ryood/ArduinoLFO/CameraZOOM-20180402085916734.jpg

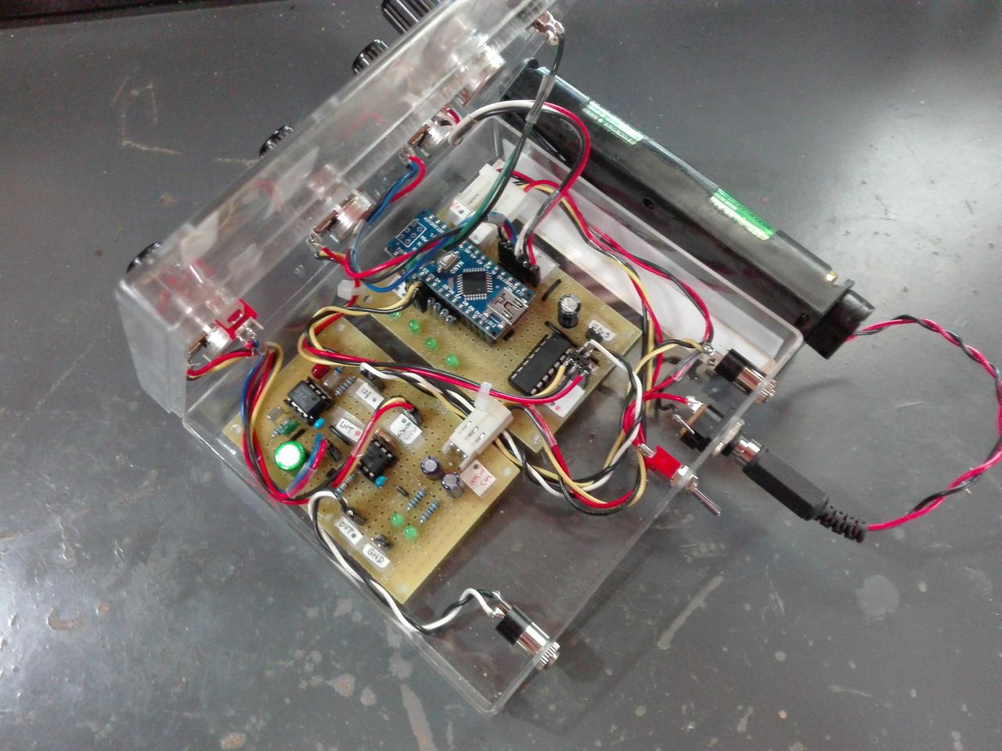
CameraZOOM-20180402085916734.jpg
