ryood/ArduinoLFO/CameraZOOM-20180402085851424.jpg

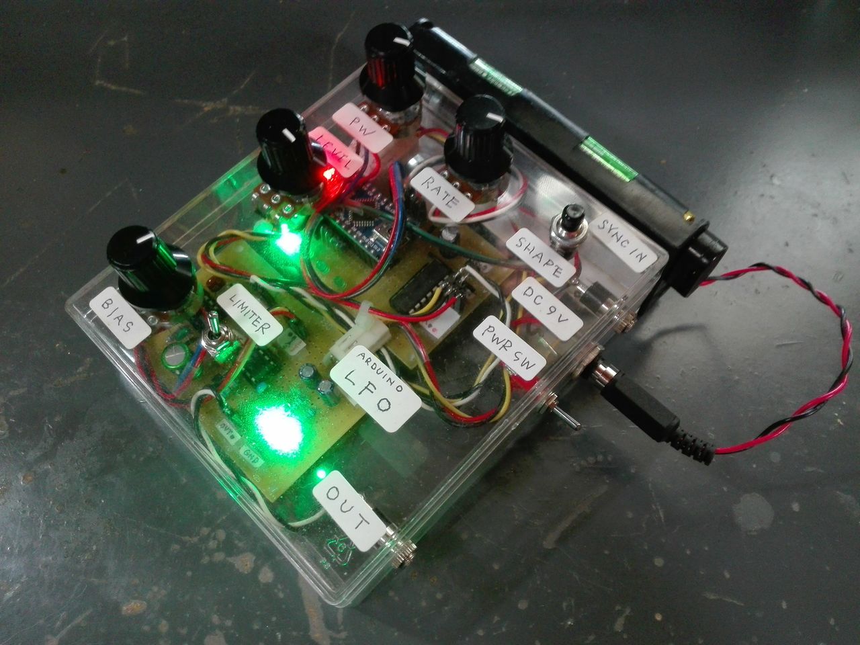
CameraZOOM-20180402085851424.jpg
