ryood/ArduinoLFO/Arduino LFO ブロック図.jpg

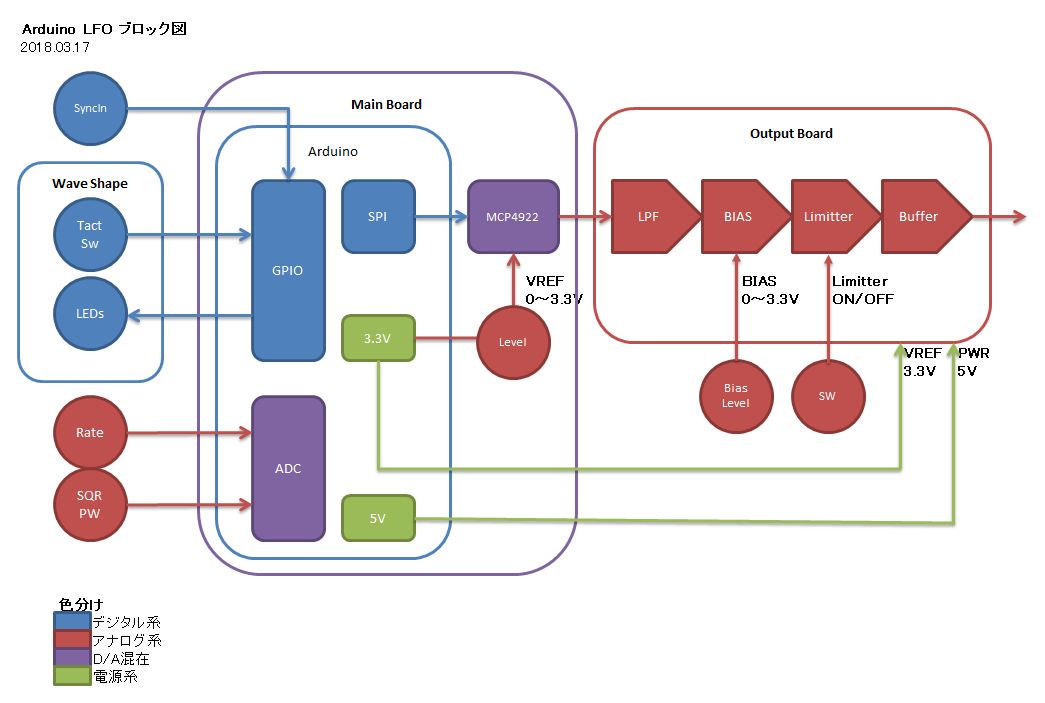
Arduino LFO ブロック図.jpg
