ryood/ArduinoLFO/ArduinoLFOケース内配線_ブレッドボード.png

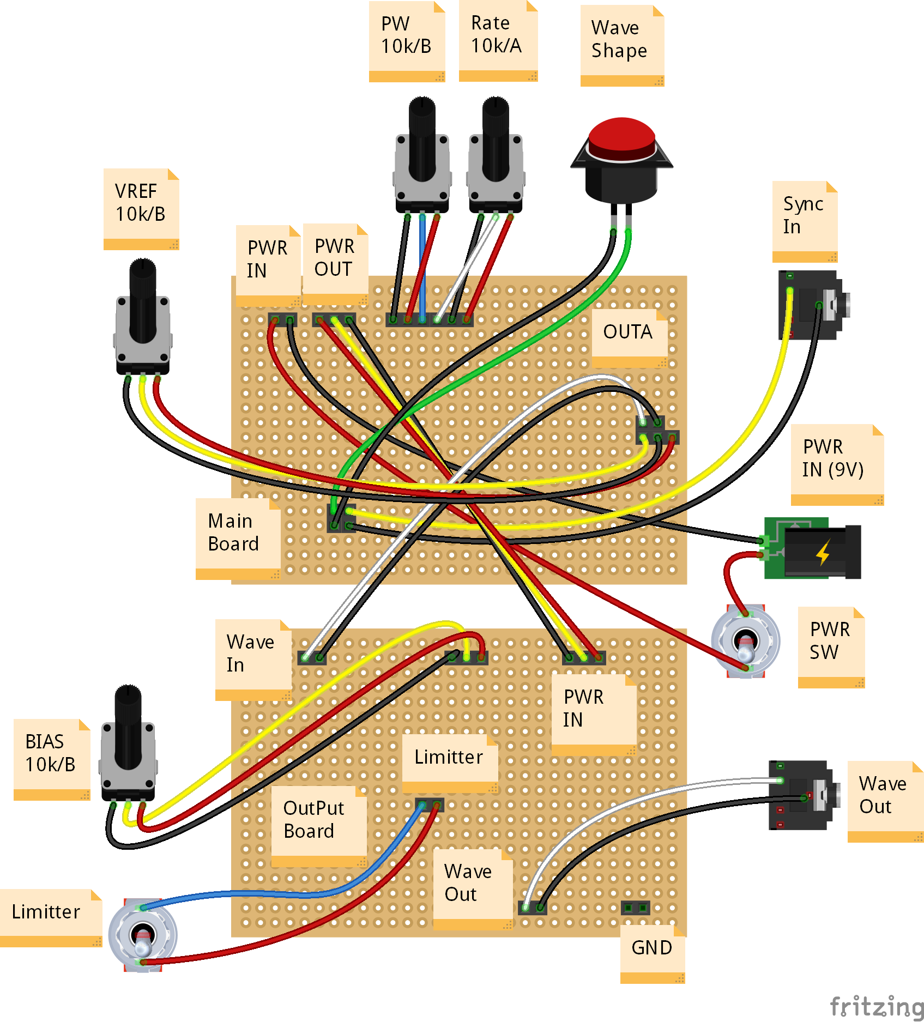
ArduinoLFOケース内配線_ブレッドボード.png
