ryood/ArduinoLFO/eagle/Arduino_LFO_MainBard_brd.png

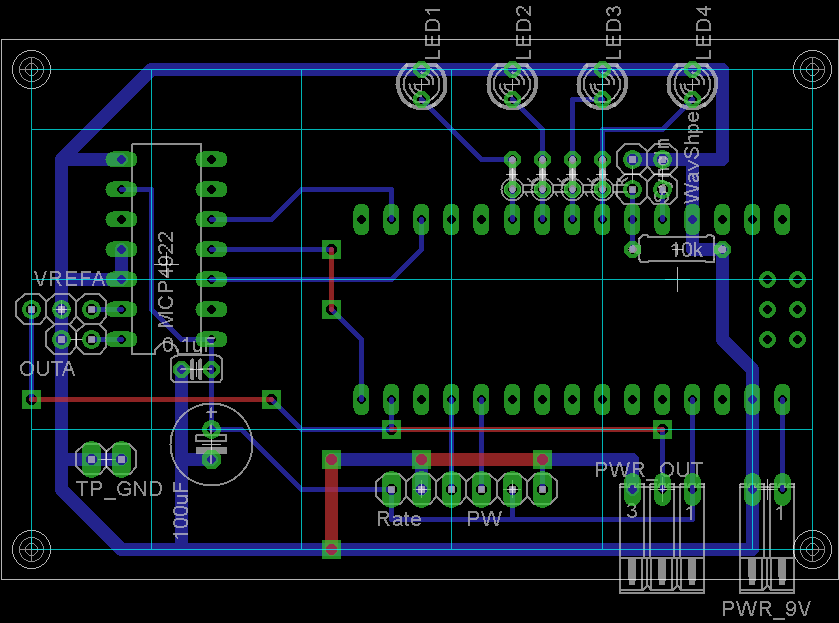
eagle/Arduino_LFO_MainBard_brd.png
