ryood/ArduinoLFO/eagle/Arduino_LFO_MainBard_sch.png

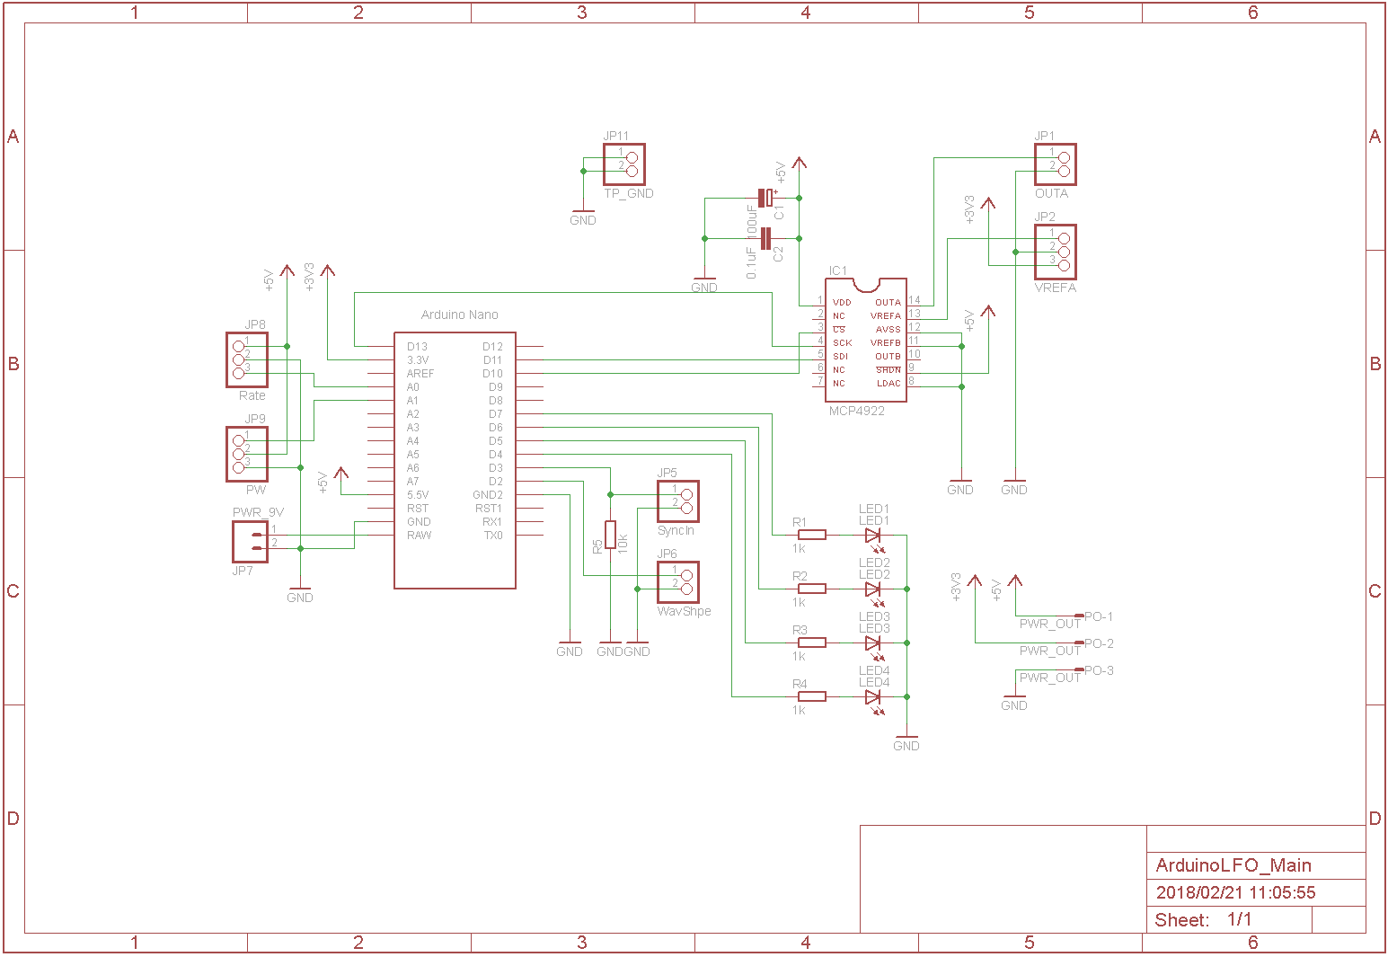
eagle/Arduino_LFO_MainBard_sch.png
