ryood/ArduinoLFO/eagle/ArduinoLFO_Output_Board_brd.png

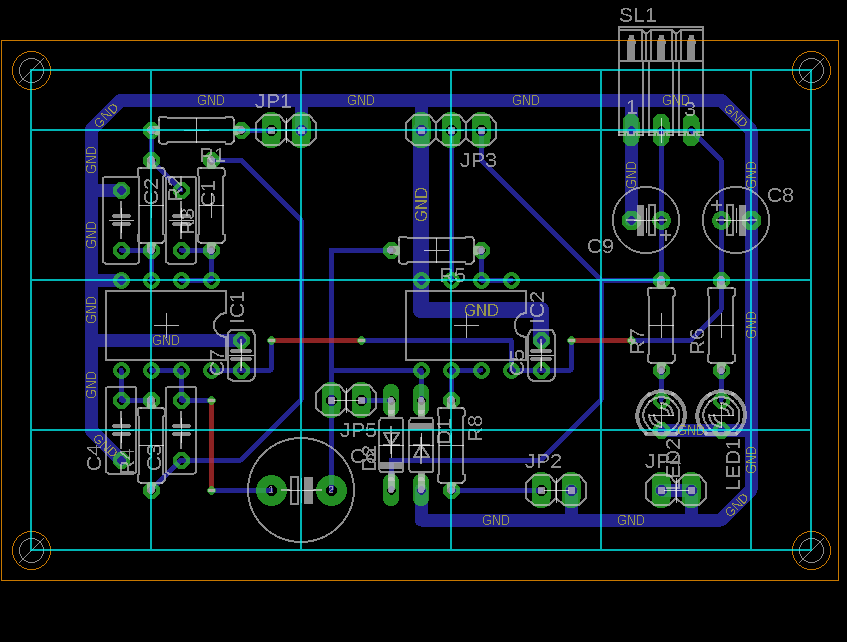
eagle/ArduinoLFO_Output_Board_brd.png
