ryood/ArduinoLFO/eagle/ArduinoLFO_Output_Board_sch.png

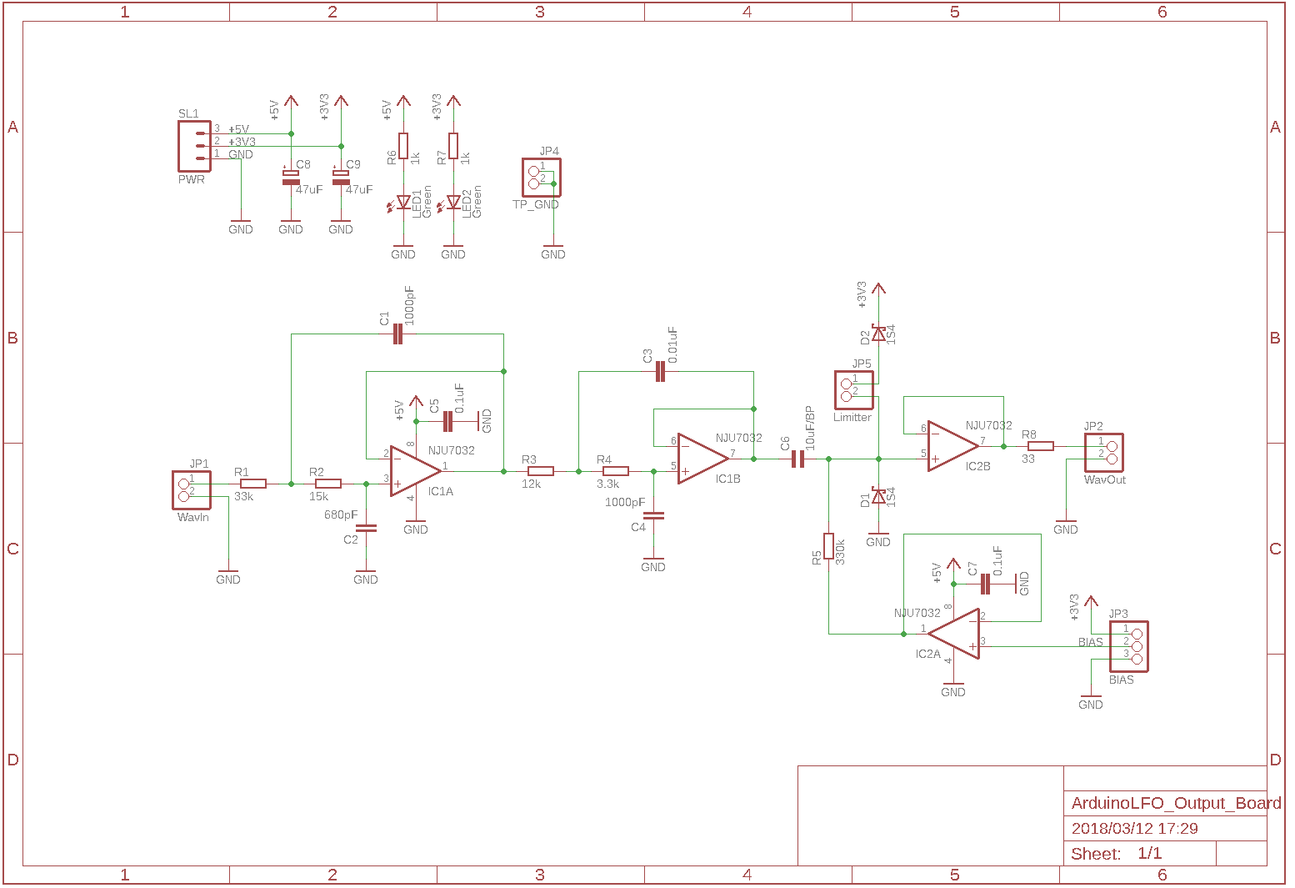
eagle/ArduinoLFO_Output_Board_sch.png
