ryood/ArduinoLFO/fritzing/ArduinoLFO_ブレッドボード.png

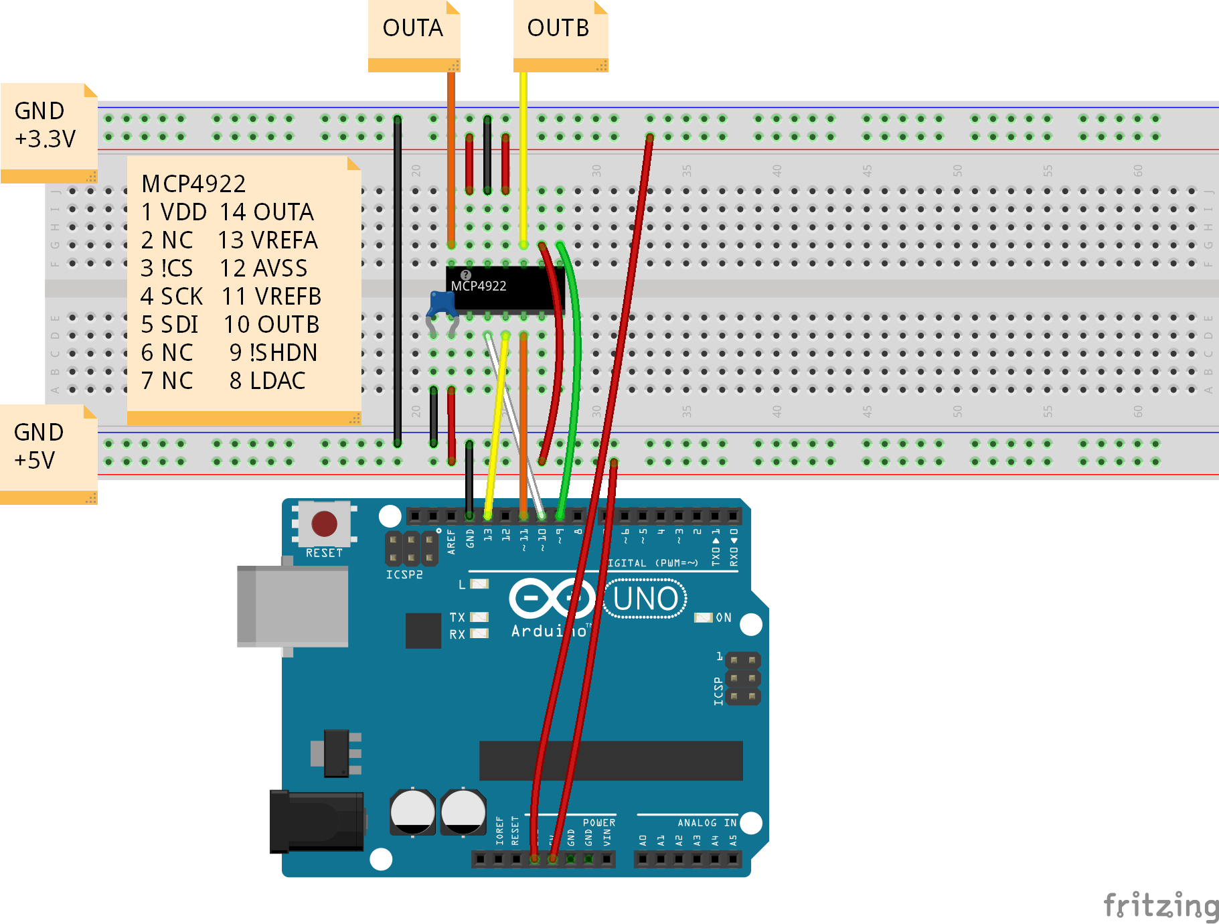
fritzing/ArduinoLFO_ブレッドボード.png
