ryood/ArduinoLFO/fritzing/ArduinoLFOwithUI_ブレッドボード.png

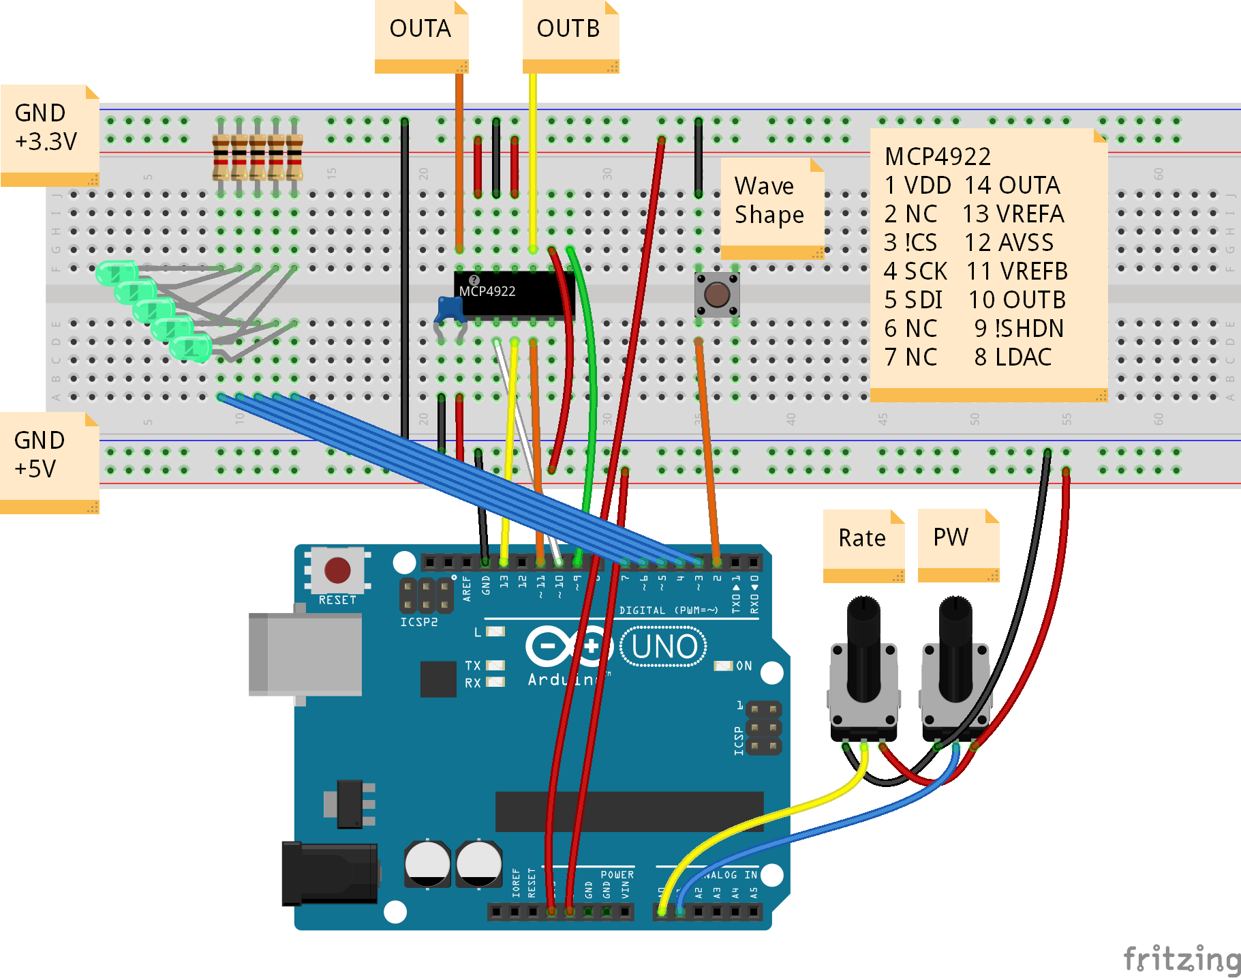
fritzing/ArduinoLFOwithUI_ブレッドボード.png
