ryood/ArduinoLFO/fritzing/ArduinoLFOケース内配線_ブレッドボード.png

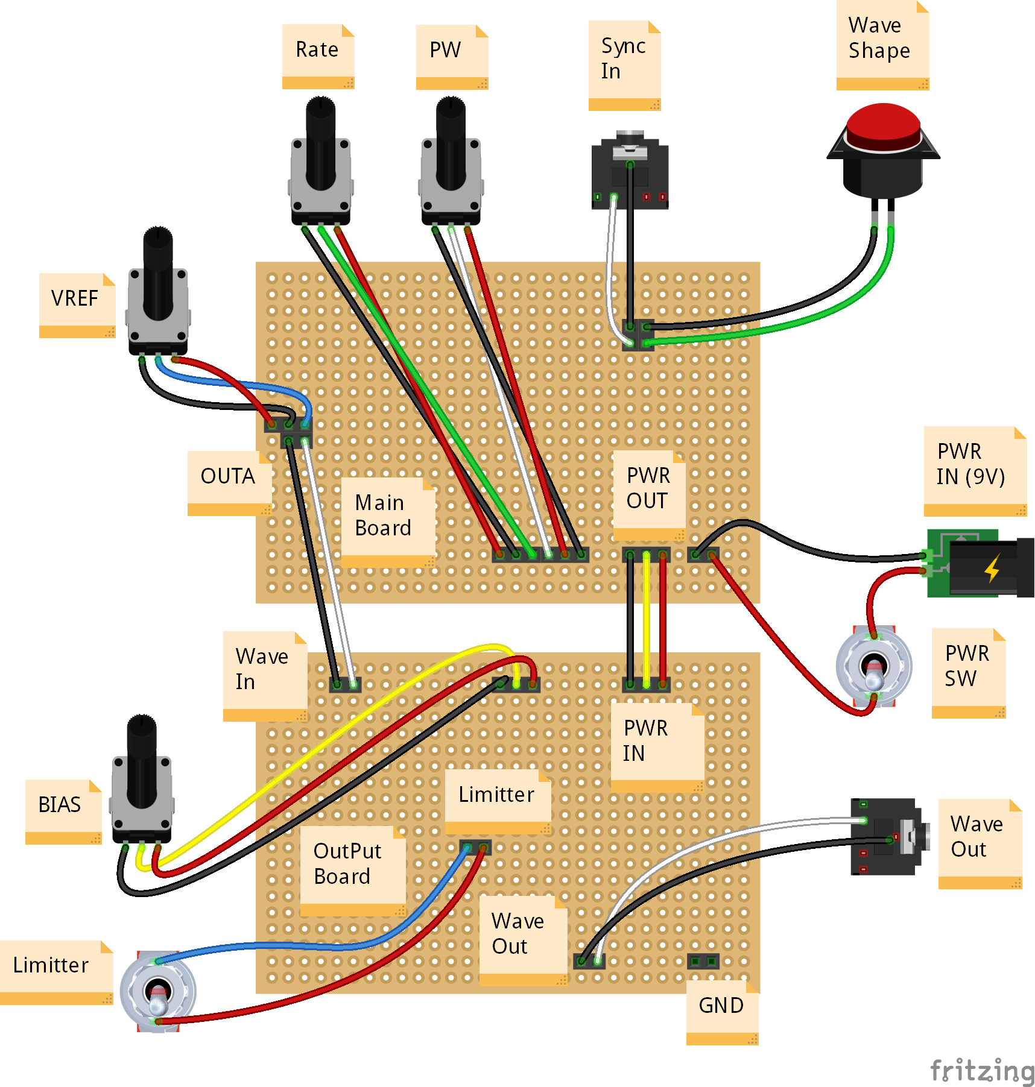
fritzing/ArduinoLFOケース内配線_ブレッドボード.png
