ryood/ArduinoLFO/LPF/fritzing/4th_Butterworth_VCVS_LPF_ブレッドボード.png

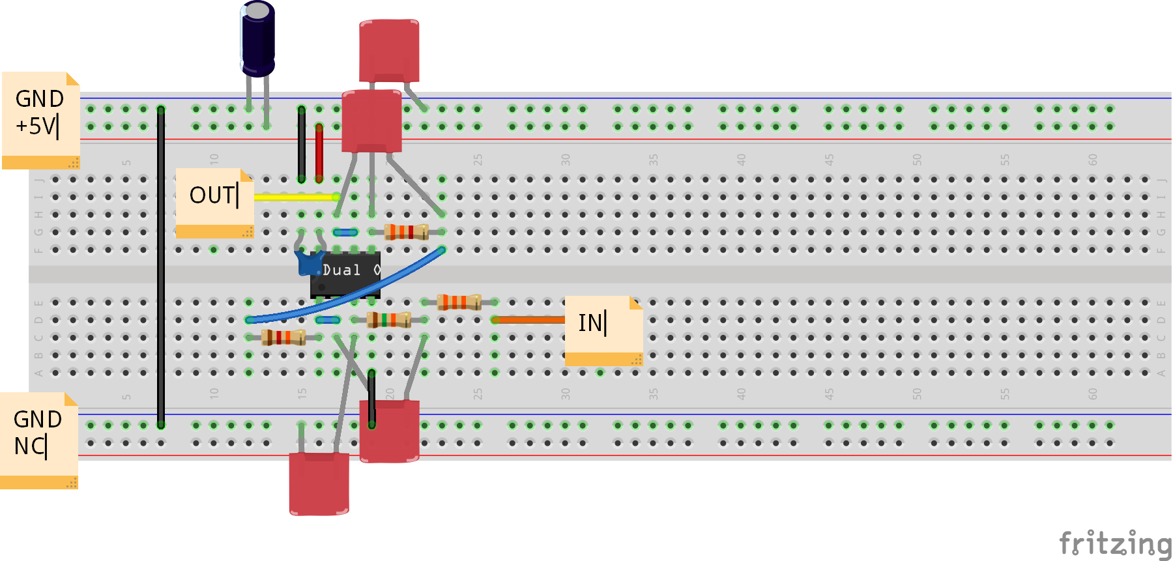
LPF/fritzing/4th_Butterworth_VCVS_LPF_ブレッドボード.png
