ryood/ArduinoLFO/Output Board/fritzing/ArduinoLFOwithUI_Output_r_ブレッドボード.png

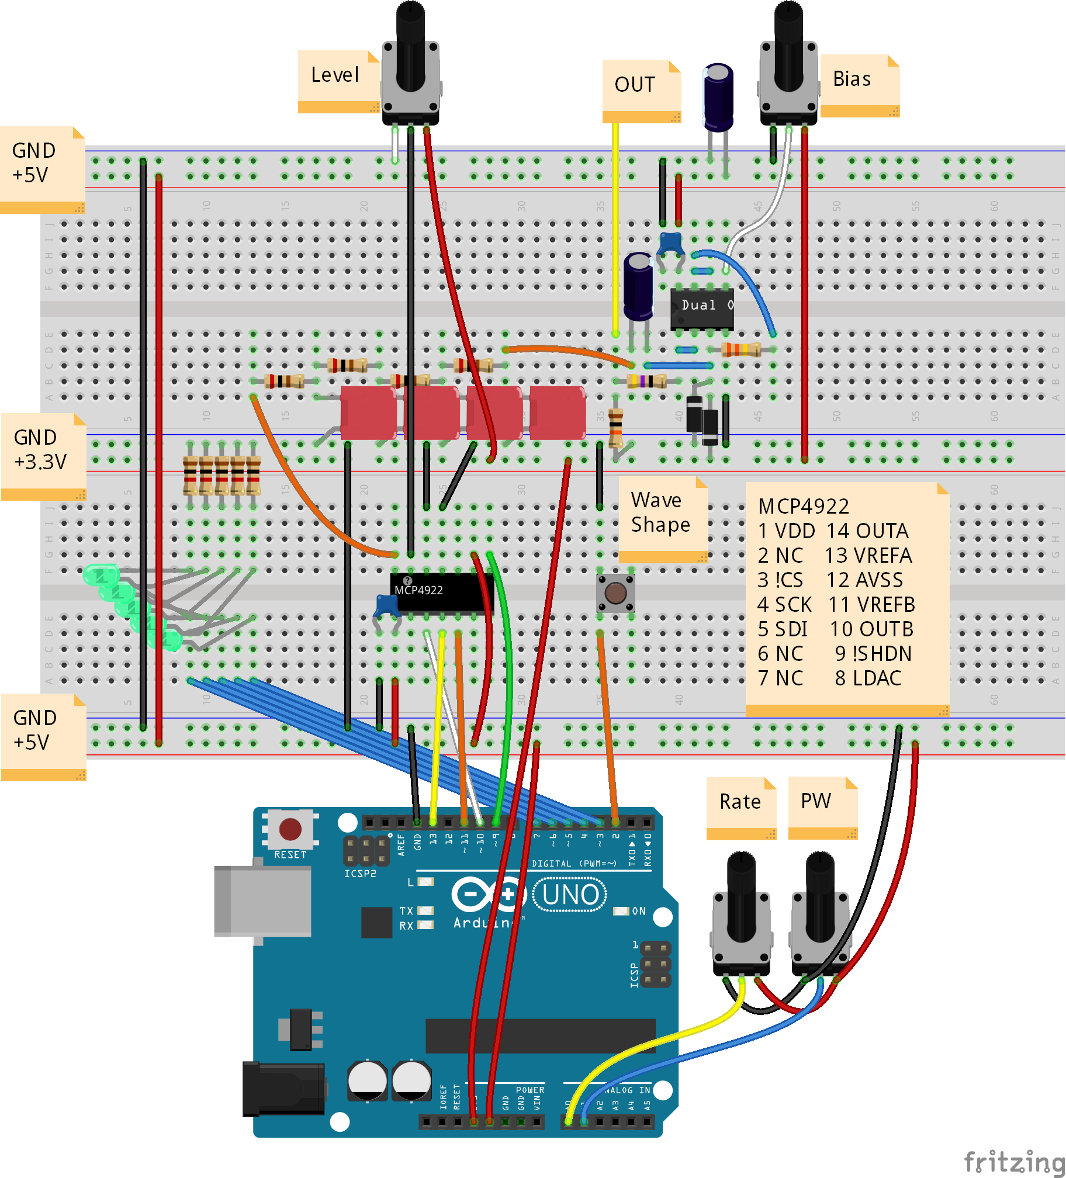
Output Board/fritzing/ArduinoLFOwithUI_Output_r_ブレッドボード.png
