ryood/ArduinoLFO/Output Board/fritzing/OutputBoard_MFB_ブレッドボード.png

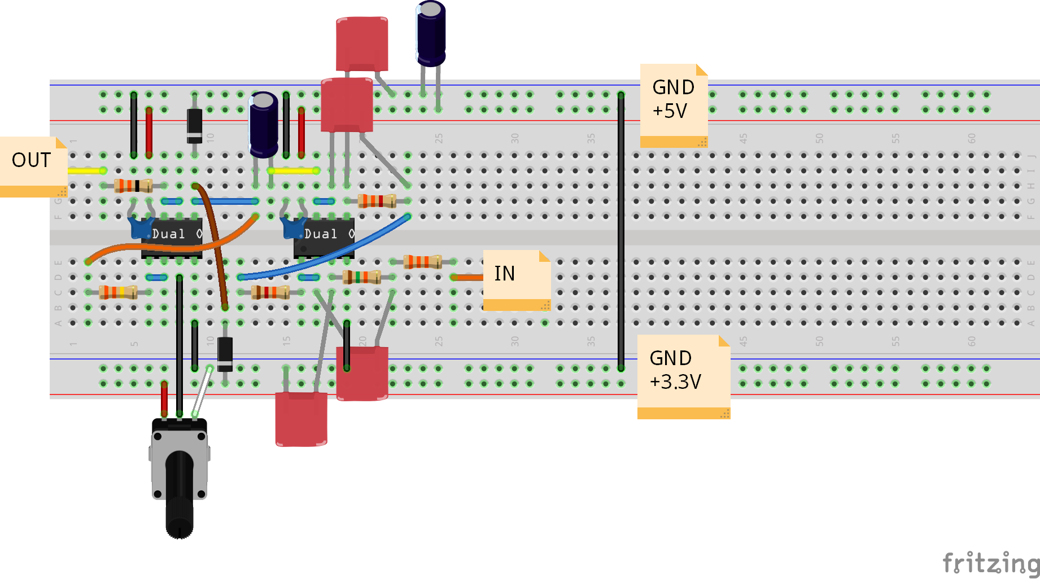
Output Board/fritzing/OutputBoard_MFB_ブレッドボード.png
