ryood/ArduinoLFO/Output Board/fritzing/OutputBoard_RC_LPF_ブレッドボード.png

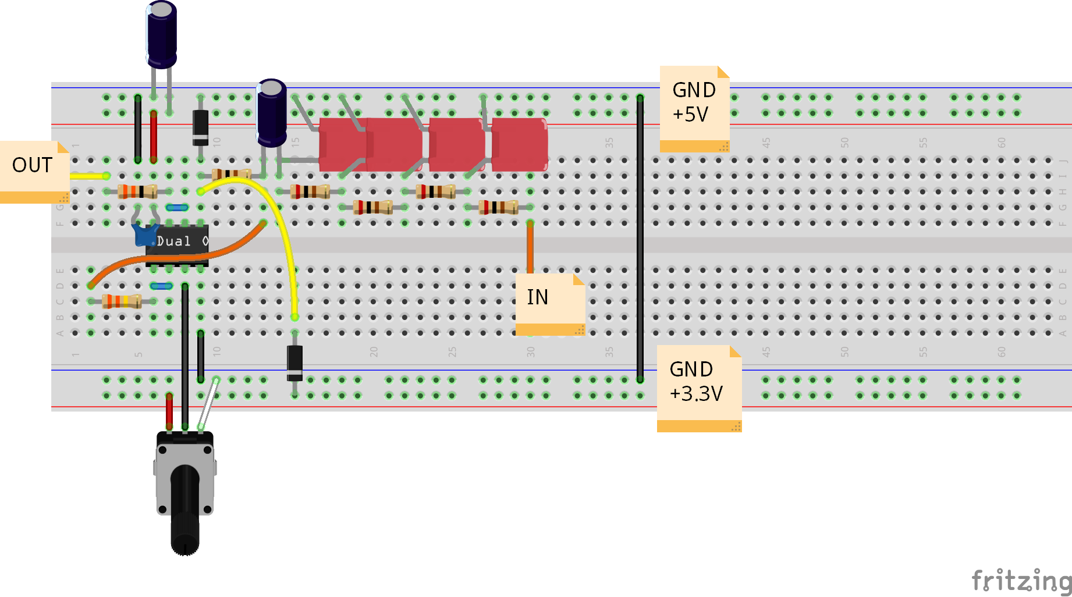
Output Board/fritzing/OutputBoard_RC_LPF_ブレッドボード.png
