ryood/ArduinoLFO/Output Board/spice/4th_MFB_sch.png

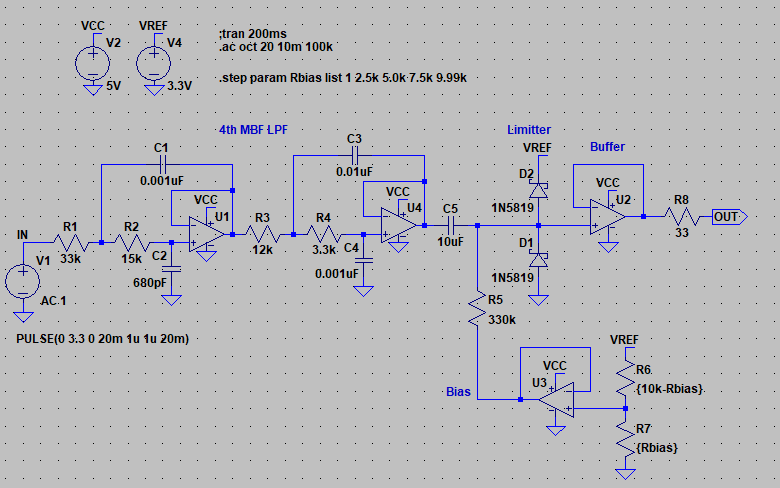
Output Board/spice/4th_MFB_sch.png
