ryood/ArduinoLFO/Output Board/spice/4th_RC_LPF_sch.png

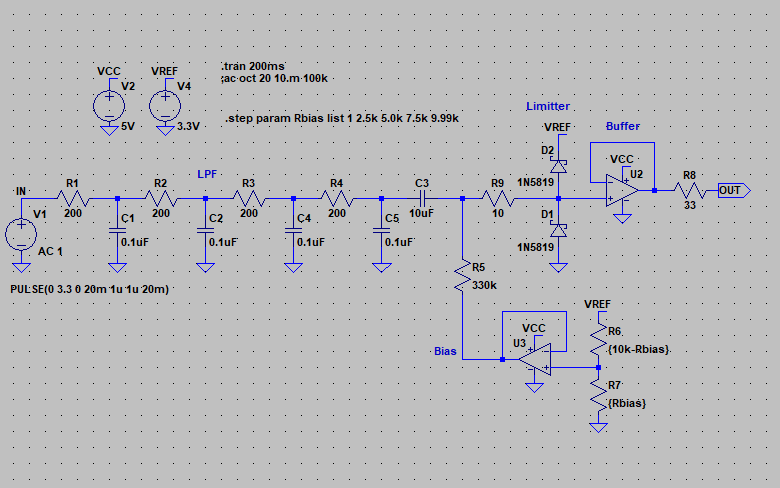
Output Board/spice/4th_RC_LPF_sch.png
