ryood/ArduinoLFO/(list of files, cad)

Other CAD files:
Case/ArduinoLFO_Case.dwg
Case/ArduinoLFO_Case_Top.dwg
