ryood/ArduinoLFO/fritzing/ArduinoLFO_MainBoard_Test_ブレッドボード.png

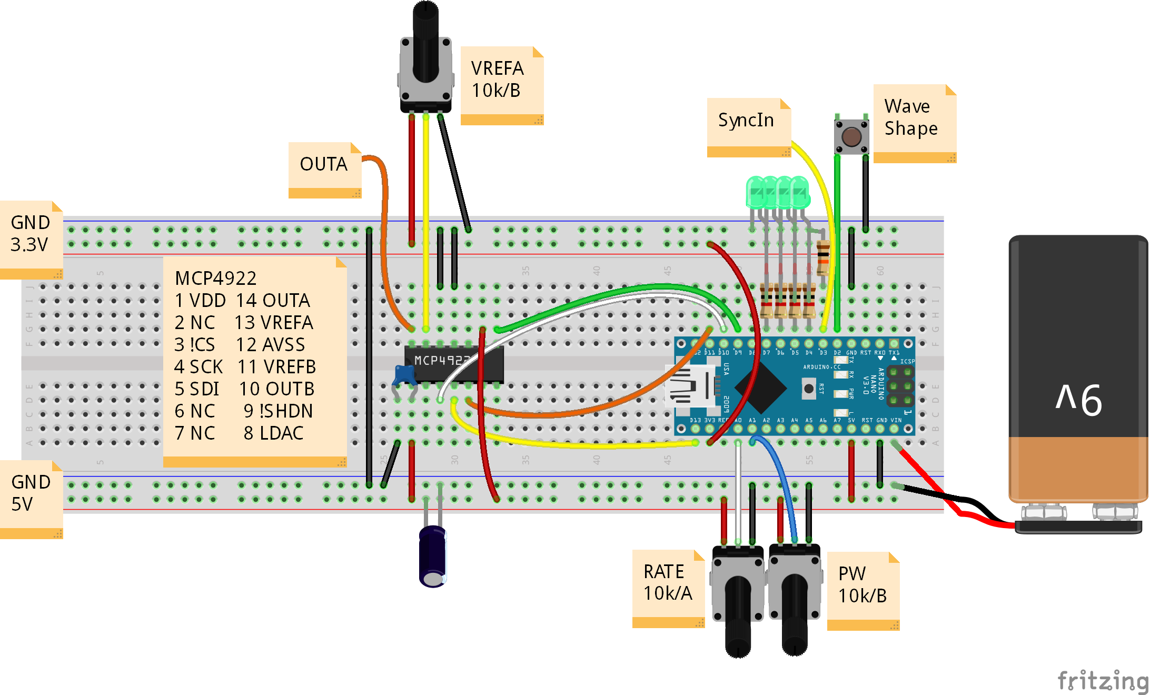
fritzing/ArduinoLFO_MainBoard_Test_ブレッドボード.png
