ryood/ArduinoLFO/Output Board/spice/Test/ArduinoLFO_Ouput_Board_Zener_Limiter_Bias.asc

C1: cap; 0.1uF
C2: cap; 0.1uF
C3: cap; 10uF
C4: cap; 0.1uF
C5: cap; 0.1uF
D1: zener; EDZV3_3B
R1: res; 200
R2: res; 200
R3: res; 200
R4: res; 200
R5: res; 330k
R6: res; {10k-Rbias}
R7: res; {Rbias}
R8: res; 33
R9: res; 33
U2: UniversalOpamp2
U3: UniversalOpamp2
V1: voltage; PULSE(0 3.3 0 20m 1u 1u 20m); AC 1
V2: voltage; 5V
V4: voltage; 3.3V
Named nets: 0, IN, OUT, VCC, VREF
.tran 60ms
;ac oct 20 10.m 100k
.step param Rbias list 1 2.5k 5.0k 7.5k 9.99k
LPF
Limitter
Bias
Buffer
