ryood/ArduinoLFO/Output Board/spice/Test/ArduinoLFO_Ouput_Board_Zener_Limiter_MFB_Bias.asc

C1: cap; 0.001uF
C2: cap; 680pF
C3: cap; 0.01uF
C4: cap; 0.001uF
C5: cap; 10uF
D1: zener; EDZV3_3B
R1: res; 33k
R2: res; 15k
R3: res; 12k
R4: res; 3.3k
R5: res; 330k
R6: res; {10k-Rbias}
R7: res; {Rbias}
R8: res; 33
R9: res; 820
U1: UniversalOpamp2
U2: UniversalOpamp2
U3: UniversalOpamp2
U4: UniversalOpamp2
V1: voltage; PULSE(0 3.3 0 20m 1u 1u 20m); AC 1
V2: voltage; 5V
V4: voltage; 3.3V
Named nets: 0, IN, OUT, VCC, VREF
;tran 200ms
.ac oct 20 10m 100k
.step param Rbias list 1 2.5k 5.0k 7.5k 9.99k
4th MBF LPF
Limitter
Bias
Buffer
