ryood/ArduinoLFO/Output Board/spice/Test/ArduinoLFO_Ouput_Board_NoInputBuffer_anti_osc_LPF.asc

C1: cap; 0.1uF
C2: cap; 0.1uF
C3: cap; 10uF
C4: cap; 0.1uF
C5: cap; 0.1uF
C6: cap; 1uF
D1: diode
D2: diode
R1: res; {Rc}
R2: res; {Rc}
R3: res; {Rc}
R4: res; {Rc}
R5: res; 330k
R6: res; 50k
R7: res; 50k
R8: res; 47
R9: res; 33
R10: res; 10k
U2: UniversalOpamp2
U3: UniversalOpamp2
V1: voltage; PULSE(0 3.3 0 1n 1n 10m 20m); AC 1
V2: voltage; 5V
V4: voltage; 3.3V
Named nets: 0, IN, OUT, VCC, VREF
.tran 0 1s 940ms
;ac oct 20 10.m 100k
.step param Rc list 47 100 200
LPF
Limitter
Bias
Buffer
