ryood/ArduinoLFO/Output Board/spice/Test/ArduinoLFO_Bias__Amp_Test.asc

C1: cap; 1uF
R1: res; 10k
R2: res; 10k
R3: res; 10k
R4: res; 10k
U1: UniversalOpamp2
U2: UniversalOpamp2
V1: voltage; SINE({Vin} {Vin} 10); AC 1
V2: voltage; 5V
V3: voltage; {Vbias}
Named nets: 0, VCC, OUT, Vbias, IN
.tran 0 1000ms 700ms
.step param Vbias list 1.65V 2V 2.5V 3V
;ac oct 20 10 10Meg
.step param Vin list 0.5 1
