ryood/ArduinoLFO/Output Board/spice/Test/ArduinoLFO_Bias_Test.asc

C1: cap; 1uF
R1: res; 10k
R2: res; 10k
U1: UniversalOpamp2
V1: voltage; SINE(1.65 1.65 10); AC 1
V2: voltage; 5V
V3: voltage; {Vbias}
Named nets: 0, VCC, OUT, Vbias, IN
.tran 300m
.step param Vbias list 0V 0.5V 1V 1.5V 2.5V 3V
;ac oct 20 10 10Meg
