ryood/ArduinoLFO/Output Board/spice/Test/ArduinoLFO_NonInv_Bias_Test.asc

C1: cap; 100uF
R1: res; 100k
U1: UniversalOpamp2
V1: voltage; SINE(1.65 1.65 1); AC 1
V2: voltage; {Vbias}
V3: voltage; 5V
Named nets: 0, VCC, OUT, IN
.step param Vbias 0V 3.3V 0.3V
.tran 3s
;ac oct 20 1m 100k
