ryood/ArduinoLFO/Output Board/spice/Test/ArduinoLFO_Ouput_Board.asc

C1: cap; 0.1uF
C2: cap; 0.1uF
C3: cap; 22uF
D1: diode
R1: res; 200
R2: res; 200
R3: res; 47
R5: res; 100k
R6: res; {10k-Rbias}
R7: res; {Rbias}
U1: UniversalOpamp2
U2: UniversalOpamp2
U3: UniversalOpamp2
V1: voltage; PULSE(0 3.3 0 1 1u 1u 1); AC 1
V2: voltage; 5V
V4: voltage; 3.3V
Named nets: 0, IN, OUT, VCC, VREF
.tran 0 10 7
;ac oct 20 10.m 100k
.step param Rbias list 1 2.5k 5.0k 7.5k 9.99k
LPF
Limitter
Bias
