ryood/ArduinoLFO/Output Board/spice/Test/ArduinoLFO_Ouput_Board_AC_Coupling.asc

C1: cap; 1uF
C2: cap; 1uF
C3: cap; 22uF
R1: res; 150
R2: res; 150
R3: res; {10k-Rlv}
R4: res; {Rlv}
R5: res; 100k
U1: UniversalOpamp2
V1: voltage; PULSE(0 3.3 0 1 1u 1u 1); AC 1
V2: voltage; 5V
Named nets: 0, IN, OUT, VCC
.tran 0 10 7
;ac oct 20 1m 100k
.param Rlv 5k
