ryood/ArduinoLFO/Output Board/spice/Test/ArduinoLFO_Ouput_Board_Bias(OPAMP)_Limitter.asc

C1: cap; 1uF
C2: cap; 1uF
C3: cap; 22uF
D1: diode
R1: res; 200
R2: res; 200
R3: res; {10k-Rlv}
R4: res; {Rlv}
R5: res; 100k
R6: res; {10k-Rbias}
R7: res; {Rbias}
R8: res; 47
U1: UniversalOpamp2
U2: UniversalOpamp2
U3: UniversalOpamp2
V1: voltage; PULSE(0 3.3 0 1 1u 1u 1); AC 1
V2: voltage; 5V
V4: voltage; 3.3V
Named nets: 0, IN, OUT, VCC, VREF
.tran 0 10 7
;ac oct 20 1m 100k
.param Rlv 5k
.step param Rbias list 1 2.5k 5.0k 7.5k 9.99k
LPF
Level
Limitter
Bias
