ryood/ArduinoLFO/Output Board/spice/ArduinoLFO_Ouput_Board_RCLPF_Fc.asc

C1: cap; 0.1uF
C2: cap; 0.1uF
C3: cap; 10uF
C4: cap; 0.1uF
C5: cap; 0.1uF
D1: schottky; 1N5819
D2: schottky; 1N5819
R1: res; {Rf}
R2: res; {Rf}
R3: res; {Rf}
R4: res; {Rf}
R5: res; 330k
R6: res; 5k
R7: res; 5k
R8: res; 33
R9: res; 10
U2: UniversalOpamp2
U3: UniversalOpamp2
V1: voltage; PULSE(0 3.3 0 20m 1u 1u 20m); AC 1
V2: voltage; 5V
V4: voltage; 3.3V
Named nets: 0, IN, OUT, VCC, VREF
;tran 0 1s 940ms
.ac oct 20 10.m 100k
.step param Rf 100 500 100
LPF
Limitter
Bias
Buffer
