ryood/ArduinoLFO/LPF/spice/ArduinoLFO_RC_4thLPF.asc

C1: cap; 0.1uF
C2: cap; 0.1uF
C3: cap; 0.1uF
C4: cap; 0.1uF
R1: res; 200
R2: res; 200
R3: res; 200
R4: res; 200
V1: voltage; PULSE(0 3.3 0 1n 1n 5m 10m); AC 1
Named nets: 0, IN, OUT
;tran 20m
.ac oct 20 100m 100k
