ryood/ArduinoLFO/LPF/spice/ArduinoLFO_RLC_LPF.asc

C1: cap; 22uF
L1: ind; 10uH
R1: res; 10
V1: voltage; PULSE(0 3.3 0 1 1u 1u 1); AC 1
Named nets: 0, IN, OUT
;tran 3
.ac oct 20 1m 100k
