ryood/ArduinoLFO/LPF/spice/ArduinoLFO_RLC_LPF_2.2uF.asc

C1: cap; 2.2uF
L1: ind; 10uH
R1: res; 4.7
V1: voltage; SINE(1.5 1.5 {F}); AC 1
Named nets: 0, IN, OUT
.tran 1m
;ac oct 20 1m 10Meg
.step param F list 2k 3k
