ryood/ArduinoLFO/LPF/spice/ArduinoLFO_VCVS_4thLPF.asc

C1: cap; 0.001uF
C2: cap; 680pF
C3: cap; 0.01uF
C4: cap; 0.01uF
R1: res; 39k
R2: res; 15k
R3: res; 12k
R4: res; 3.3k
U1: UniversalOpamp2
U2: UniversalOpamp2
V1: voltage; PULSE(0 1 0 1n 1n 0.5m 1m); AC 1
V2: voltage; 5V
Named nets: 0, VCC, OUT, IN
.ac oct 20 1 100k
;tran 2m
