ryood/ArduinoLFO/LPF/spice/ArduinoLFO_VCVS_4thLPF_1stStage.asc

C1: cap; 0.001uF
C2: cap; 1000pF
R1: res; 33k
R2: res; 15k
U1: UniversalOpamp2
V1: voltage; PULSE(0 1 0 1n 1n 0.5m 1m); AC 1
V2: voltage; 5V
Named nets: 0, VCC, OUT, IN
;ac oct 20 1 100k
.tran 2m
