ryood/ArduinoLFO/(list of files, drawings)

Other design files:
fritzing/ArduinoLFO.fzz
fritzing/ArduinoLFO_MainBoard_Test.fzz
fritzing/ArduinoLFO_MainBoard_Test_修正.fzz
fritzing/ArduinoLFOwithUI.fzz
fritzing/ArduinoLFOケース内配線.fzz
LPF/fritzing/4th_Butterworth_VCVS_LPF.fzz
Output Board/fritzing/ArduinoLFOwithUI_Output.fzz
Output Board/fritzing/ArduinoLFOwithUI_Output_r.fzz
Output Board/fritzing/OutputBoard_MFB.fzz
Output Board/fritzing/OutputBoard_RC_LPF.fzz
