ryood/ArduinoLFO/eagle/ArduinoLFO_Output_Board/ArduinoLFO_Output_Board.brd

## EAGLE design eagle/ArduinoLFO_Output_Board/ArduinoLFO_Output_Board.brd (2018-03-19)

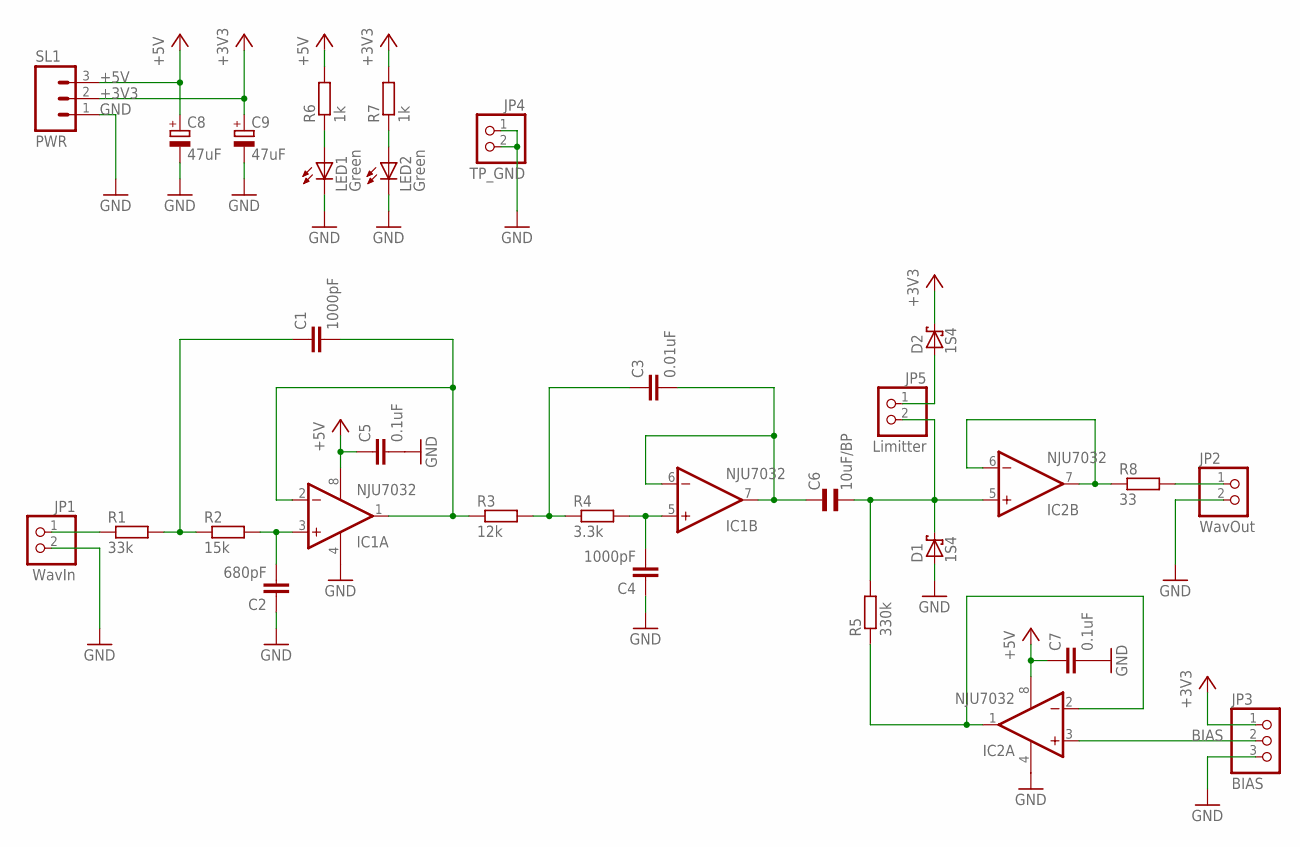
[picture p19: schematic ArduinoLFO_Output_Board.sch]

Parts:
C1, C4: 1000pF; C050-025X075
C2: 680pF; C050-030X075
C3: 0.01uF; C050-025X075
C5, C7: 0.1uF; C025-024X044
C6: 10uF/BP; E5-8,5
C8, C9: 47uF; E2,5-6
D1, D2: 1S4; DO35-7
IC1, IC2: NJU7032; DIL08
JP1: WavIn; 1X02
JP2: WavOut; 1X02
JP3: BIAS; 1X03
JP4: TP_GND; 1X02
JP5: Limitter; 1X02
LED1, LED2: Green; LED3MM
R1: 33k; 0207/7
R2: 15k; 0207/7
R3: 12k; 0207/7
R4: 3.3k; 0207/7
R5: 330k; 0207/7
R6, R7: 1k; 0207/7
R8: 33; 0207/7
SL1: PWR; 03PA

Connections:
+3V3: C9.+, D2.C, JP3.1, R7.2, SL1.2
+5V: C5.1, C7.1, C8.+, IC1.8 (V+), IC2.8 (V+), R6.2, SL1.3
BIAS: IC2.3 (+IN), JP3.2
GND: C2.1, C4.1, C5.2, C7.2, C8.-, C9.-, D1.A, IC1.4 (V-), IC2.4 (V-), JP1.2, JP2.2, JP3.3, JP4.1, JP4.2, LED1.K (C), LED2.K (C), SL1.1
unnamed: JP1.1, R1.1
unnamed: C1.1, R1.2, R2.1
unnamed: C2.2, IC1.3 (+IN), R2.2
unnamed: C1.2, IC1.1 (OUT), IC1.2 (-IN), R3.1
unnamed: C3.1, R3.2, R4.1
unnamed: C4.2, IC1.5 (+IN), R4.2
unnamed: C3.2, C6.1, IC1.6 (-IN), IC1.7 (OUT)
unnamed: C6.2, D1.C, IC2.5 (+IN), JP5.2, R5.2
unnamed: IC2.6 (-IN), IC2.7 (OUT), R8.1
unnamed: IC2.1 (OUT), IC2.2 (-IN), R5.1
unnamed: JP2.1, R8.2
unnamed: LED1.A, R6.1
unnamed: LED2.A, R7.1
unnamed: D2.A, JP5.1

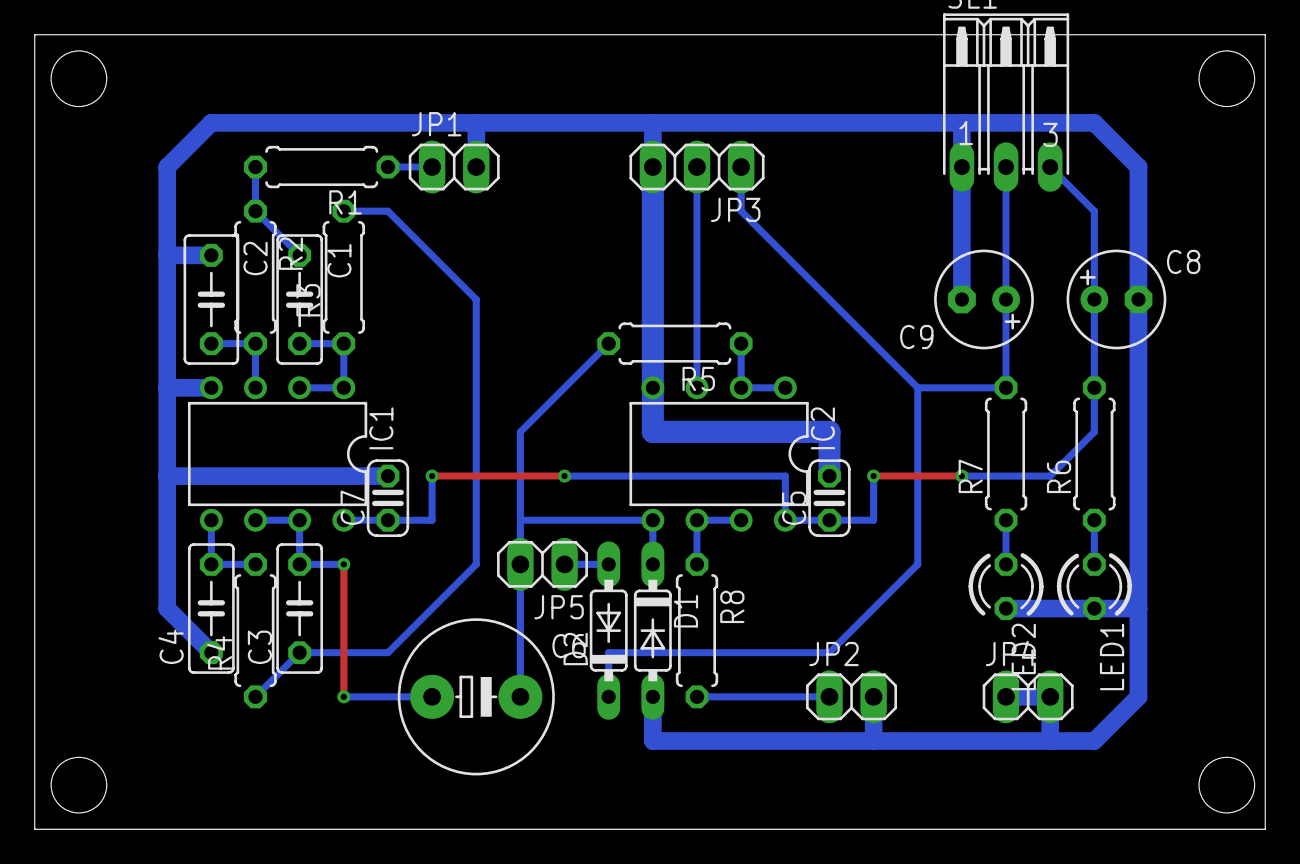
[picture p20: board ArduinoLFO_Output_Board.brd from above]

Board: 2 copper layers, 70.8 x 45.7 mm, 29 parts (0 on the bottom side), 18 nets.
