ryood/ArduinoLFO/eagle/ArduinoLFO_Main/ArduinoLFO_Main.brd

## EAGLE design eagle/ArduinoLFO_Main/ArduinoLFO_Main.brd (2018-02-25)

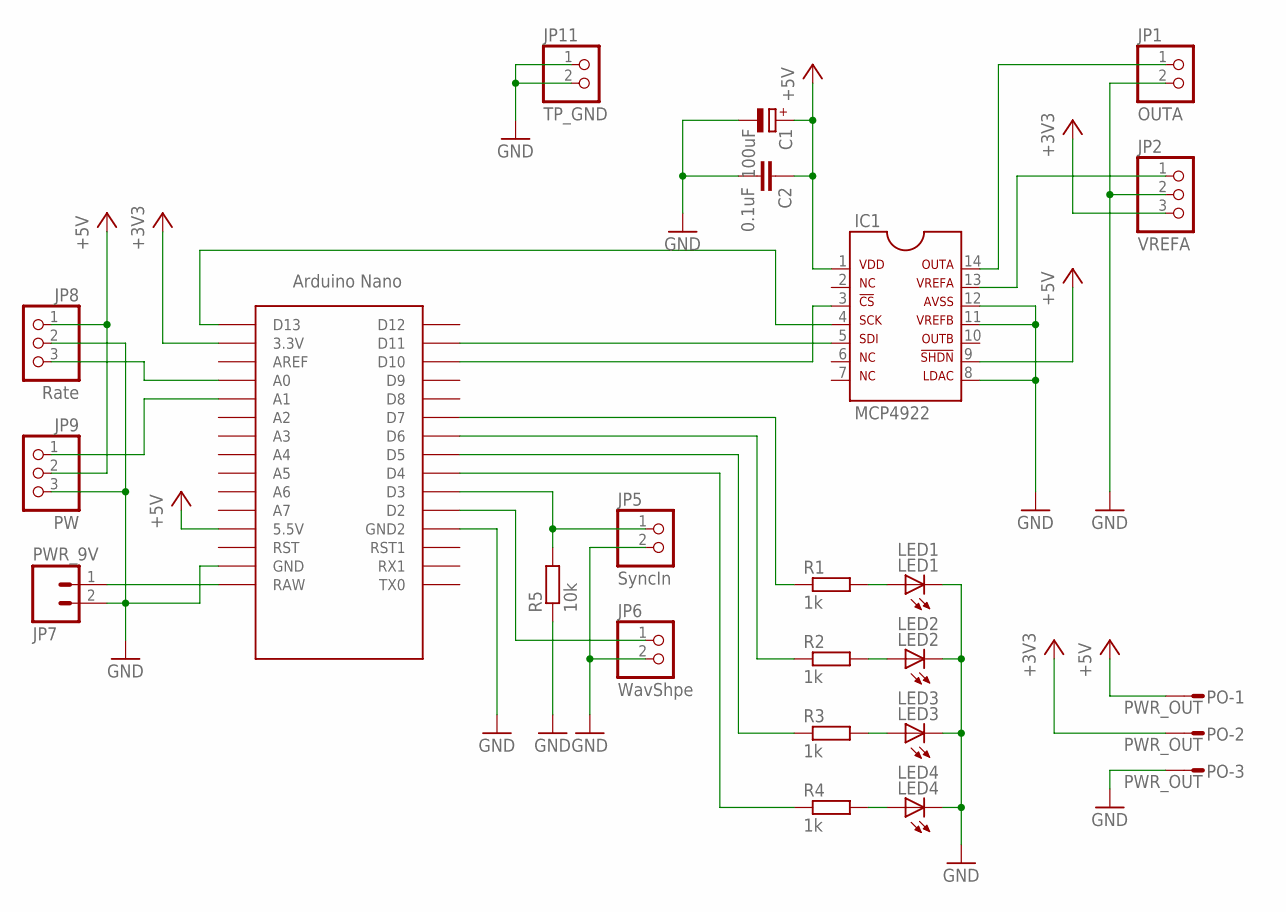
[picture p21: schematic ArduinoLFO_Main.sch]

Parts:
C1: 100uF; E2,5-7
C2: 0.1uF; C025-024X044
IC1: MCP4922
JP1: OUTA; 1X02
JP2: VREFA; 1X03
JP5: SyncIn; 1X02
JP6: WavShpe; 1X02
JP7: PWR_9V; 02PA
JP8: Rate; 1X03
JP9: PW; 1X03
JP11: TP_GND; 1X02
LED1: LED1; LED3MM
LED2: LED2; LED3MM
LED3: LED3; LED3MM
LED4: LED4; LED3MM
PO: PWR_OUT; 03PA
R1, R2, R3, R4: 1k; 0204V
R5: 10k; 0207/7
U$1: NANO

Connections:
+3V3: JP2.3, PO.2, U$1.3.3V
+5V: C1.+, C2.1, IC1.1, IC1.9, JP8.1, JP9.2, PO.1, U$1.5V (5.5V)
GND: C1.-, C2.2, IC1.8, IC1.11, IC1.12, JP1.2, JP2.2, JP5.2, JP6.2, JP7.2, JP8.2, JP9.3, JP11.1, JP11.2, LED1.K (C), LED2.K (C), LED3.K (C), LED4.K (C), PO.3, R5.1, U$1.GND, U$1.GND1 (GND2)
unnamed: IC1.4, U$1.D13
unnamed: IC1.5, U$1.D11
unnamed: IC1.3, U$1.D10
unnamed: JP8.3, U$1.A0
unnamed: IC1.14, JP1.1
unnamed: IC1.13, JP2.1
unnamed: JP9.1, U$1.A1
unnamed: JP7.1, U$1.RAW
unnamed: LED1.A, R1.2
unnamed: LED2.A, R2.2
unnamed: LED3.A, R3.2
unnamed: LED4.A, R4.2
unnamed: R1.1, U$1.D7
unnamed: R2.1, U$1.D6
unnamed: R3.1, U$1.D5
unnamed: R4.1, U$1.D4
unnamed: JP5.1, R5.2, U$1.D3
unnamed: JP6.1, U$1.D2

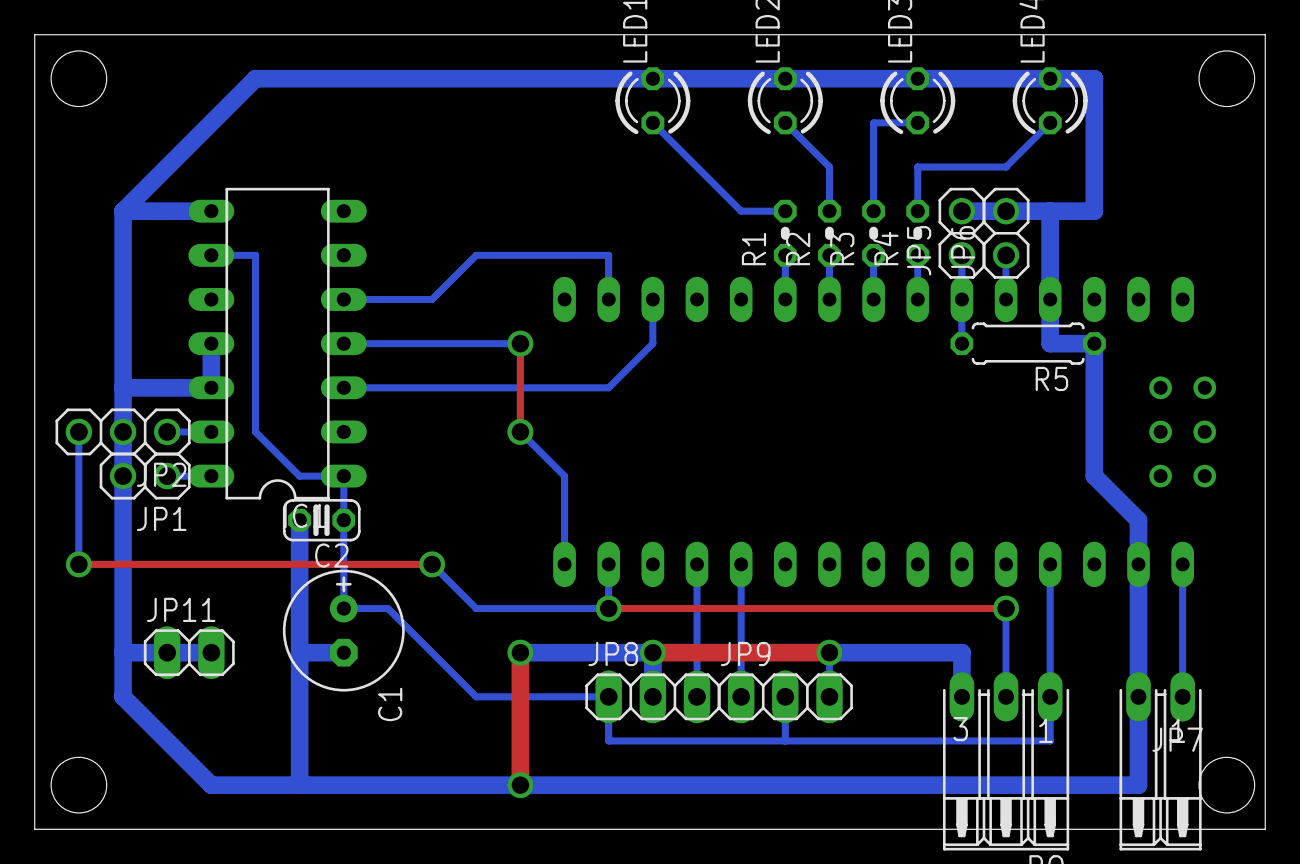
[picture p22: board ArduinoLFO_Main.brd from above]

Board: 2 copper layers, 70.8 x 45.7 mm, 22 parts (0 on the bottom side), 21 nets.
