ryood/ArduinoLFO/Arduino/MCP4922_OSC/wavetable_12bit_2k.h

/*
 * wavetable_12bit_2k.h
 * 
 * 2018.01.24
 * 
 */

#ifndef _WAVETABLE_12bit_2k_H_
#define _WAVETABLE_12bit_2k_H_

// table of 2048 values / one period / stored in flash memory
/*** MAX_VALUE = 4096 SAMPLE_NUM = 2048 delta = 1.999512***/
/*** sine wave ***/
const PROGMEM uint16_t sin_12bit_2k[] = {
	2047	,
	2053	,
	2060	,
	2066	,
	2072	,
	2078	,
	2085	,
	2091	,
	2097	,
	2104	,
	2110	,
	2116	,
	2122	,
	2129	,
	2135	,
	2141	,
	2147	,
	2154	,
	2160	,
	2166	,
	2173	,
	2179	,
	2185	,
	2191	,
	2198	,
	2204	,
	2210	,
	2216	,
	2223	,
	2229	,
	2235	,
	2241	,
	2248	,
	2254	,
	2260	,
	2266	,
	2273	,
	2279	,
	2285	,
	2291	,
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
};
/*** triangle wave ***/
const PROGMEM uint16_t tri_12bit_2k[] = {
  2051  ,
  2055  ,
  2059  ,
  2063  ,
  2067  ,
  2071  ,
  2075  ,
  2079  ,
  2083  ,
  2087  ,
  2091  ,
  2095  ,
  2099  ,
  2103  ,
  2107  ,
  2111  ,
  2115  ,
  2119  ,
  2123  ,
  2127  ,
  2131  ,
  2135  ,
  2139  ,
  2143  ,
  2147  ,
  2151  ,
  2155  ,
  2159  ,
  2163  ,
  2167  ,
  2171  ,
  2175  ,
  2179  ,
  2183  ,
  2187  ,
  2191  ,
  2195  ,
  2199  ,
  2203  ,
  2207  ,
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
};
/*** squre wave ***/
const PROGMEM uint16_t sqr_12bit_2k[] = {
	4095	,
	4095	,
	4095	,
	4095	,
	4095	,
	4095	,
	4095	,
	4095	,
	4095	,
	4095	,
	4095	,
	4095	,
	4095	,
	4095	,
	4095	,
	4095	,
	4095	,
	4095	,
	4095	,
	4095	,
	4095	,
	4095	,
	4095	,
	4095	,
	4095	,
	4095	,
	4095	,
	4095	,
	4095	,
	4095	,
	4095	,
	4095	,
	4095	,
	4095	,
	4095	,
	4095	,
	4095	,
	4095	,
	4095	,
	4095	,
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
};
/*** sawtooth upword wave ***/
const PROGMEM uint16_t sawup_12bit_2k[] = {
	0	,
	1	,
	3	,
	5	,
	7	,
	9	,
	11	,
	13	,
	15	,
	17	,
	19	,
	21	,
	23	,
	25	,
	27	,
	29	,
	31	,
	33	,
	35	,
	37	,
	39	,
	41	,
	43	,
	45	,
	47	,
	49	,
	51	,
	53	,
	55	,
	57	,
	59	,
	61	,
	63	,
	65	,
	67	,
	69	,
	71	,
	73	,
	75	,
	77	,
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
};
/*** sawtooth downword wave ***/
const PROGMEM uint16_t sawdown_12bit_2k[] = {
	4093	,
	4091	,
	4089	,
	4087	,
	4085	,
	4083	,
	4081	,
	4079	,
	4077	,
	4075	,
	4073	,
	4071	,
	4069	,
	4067	,
	4065	,
	4063	,
	4061	,
	4059	,
	4057	,
	4055	,
	4053	,
	4051	,
	4049	,
	4047	,
	4045	,
	4043	,
	4041	,
	4039	,
	4037	,
	4035	,
	4033	,
	4031	,
	4029	,
	4027	,
	4025	,
	4023	,
	4021	,
	4019	,
	4017	,
	4015	,
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
};

#endif _WAVETABLE_12bit_2k_H_
