ryood/ArduinoLFO/Arduino/MCP4922_OSC/wavetable_12bit_4k.h

/*
 * wavetable_12bit_4k.h
 * 
 * 2018.01.24
 * 
 */

#ifndef _WAVETABLE_12bit_4k_H_
#define _WAVETABLE_12bit_4k_H_

// table of 4096 values / one period / stored in flash memory

/*** MAX_VALUE = 4096 SAMPLE_NUM = 4096 ***/
/*** sine wave ***/
const PROGMEM  uint16_t sin_12bit_4k[]  = {
	2047	,
	2050	,
	2053	,
	2056	,
	2060	,
	2063	,
	2066	,
	2069	,
	2072	,
	2075	,
	2078	,
	2082	,
	2085	,
	2088	,
	2091	,
	2094	,
	2097	,
	2100	,
	2104	,
	2107	,
	2110	,
	2113	,
	2116	,
	2119	,
	2122	,
	2126	,
	2129	,
	2132	,
	2135	,
	2138	,
	2141	,
	2144	,
	2147	,
	2151	,
	2154	,
	2157	,
	2160	,
	2163	,
	2166	,
	2169	,
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
};
/*** triangle wave ***/
const PROGMEM  uint16_t tri_12bit_4k[]  = {
	2048	,
	2050	,
	2052	,
	2054	,
	2056	,
	2058	,
	2060	,
	2062	,
	2064	,
	2066	,
	2068	,
	2070	,
	2072	,
	2074	,
	2076	,
	2078	,
	2080	,
	2082	,
	2084	,
	2086	,
	2088	,
	2090	,
	2092	,
	2094	,
	2096	,
	2098	,
	2100	,
	2102	,
	2104	,
	2106	,
	2108	,
	2110	,
	2112	,
	2114	,
	2116	,
	2118	,
	2120	,
	2122	,
	2124	,
	2126	,
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
};
/*** squre wave ***/
const PROGMEM  uint16_t sqr_12bit_4k[]  = {
	4095	,
	4095	,
	4095	,
	4095	,
	4095	,
	4095	,
	4095	,
	4095	,
	4095	,
	4095	,
	4095	,
	4095	,
	4095	,
	4095	,
	4095	,
	4095	,
	4095	,
	4095	,
	4095	,
	4095	,
	4095	,
	4095	,
	4095	,
	4095	,
	4095	,
	4095	,
	4095	,
	4095	,
	4095	,
	4095	,
	4095	,
	4095	,
	4095	,
	4095	,
	4095	,
	4095	,
	4095	,
	4095	,
	4095	,
	4095	,
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
};
/*** sawtooth upword wave ***/
const PROGMEM  uint16_t sawup_12bit_4k[]  = {	0	,
	1	,
	2	,
	3	,
	4	,
	5	,
	6	,
	7	,
	8	,
	9	,
	10	,
	11	,
	12	,
	13	,
	14	,
	15	,
	16	,
	17	,
	18	,
	19	,
	20	,
	21	,
	22	,
	23	,
	24	,
	25	,
	26	,
	27	,
	28	,
	29	,
	30	,
	31	,
	32	,
	33	,
	34	,
	35	,
	36	,
	37	,
	38	,
	39	,
	40	,
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
};
/*** sawtooth downword wave ***/
const PROGMEM  uint16_t sawdown_12bit_4k[]  = {
	4095	,
	4094	,
	4093	,
	4092	,
	4091	,
	4090	,
	4089	,
	4088	,
	4087	,
	4086	,
	4085	,
	4084	,
	4083	,
	4082	,
	4081	,
	4080	,
	4079	,
	4078	,
	4077	,
	4076	,
	4075	,
	4074	,
	4073	,
	4072	,
	4071	,
	4070	,
	4069	,
	4068	,
	4067	,
	4066	,
	4065	,
	4064	,
	4063	,
	4062	,
	4061	,
	4060	,
	4059	,
	4058	,
	4057	,
	4056	,
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
};

#endif // _WAVETABLE_12bit_4k_H_
