ryood/ArduinoLFO/Arduino/MCP4922_LFO/wavetable_12bit_16k.h

/*
 * wavetable_12bit_16k.h
 * 
 * 2018.01.21
 * 
 */

#ifndef _WAVETABLE_12bit_16k_H_
#define _WAVETABLE_12bit_16k_H_

// table of 16384 values / one period / stored in flash memory
const PROGMEM  uint16_t sin_12bit_16k[]  = {
  2047,
  2048,
  2049,
  2049,
  2050,
  2051,
  2052,
  2052,
  2053,
  2054,
  2055,
  2056,
  2056,
  2057,
  2058,
  2059,
  2060,
  2060,
  2061,
  2062,
  2063,
  2063,
  2064,
  2065,
  2066,
  2067,
  2067,
  2068,
  2069,
  2070,
  2071,
  2071,
  2072,
  2073,
  2074,
  2074,
  2075,
  2076,
  2077,
  2078,
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
};

#endif // _WAVETABLE_12bit_16k_H_
