ryood/ArduinoLFO/Arduino/MCP4922_OSC/wavetable_12bit_8k.h

/*
 * wavetable_12bit_8k.h
 * 
 * 2018.01.21
 * 
 */

#ifndef _WAVETABLE_12bit_8k_H_
#define _WAVETABLE_12bit_8k_H_

// table of 8192 values / one period / stored in flash memory
const PROGMEM  uint16_t sin_12bit_8k[]  = {
  2047,
  2049,
  2050,
  2052,
  2053,
  2055,
  2056,
  2058,
  2060,
  2061,
  2063,
  2064,
  2066,
  2067,
  2069,
  2071,
  2072,
  2074,
  2075,
  2077,
  2078,
  2080,
  2082,
  2083,
  2085,
  2086,
  2088,
  2089,
  2091,
  2093,
  2094,
  2096,
  2097,
  2099,
  2100,
  2102,
  2104,
  2105,
  2107,
  2108,
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
};

#endif // _WAVETABLE_12bit_8k_H_
