ryood/ArduinoLFO/Arduino/MCP4922_DDS_WaveTableSize_Test/wavetable_12bit_1k.h

/*
 * wavetable_12bit_1k.h
 * 
 * 2018.01.29
 * 
 */

#ifndef _WAVETABLE_12bit_1k_H_
#define _WAVETABLE_12bit_1k_H_

// table of 2048 values / one period / stored in flash memory/*** MAX_VALUE = 4096 SAMPLE_NUM = 1024 delta = 3.999023***/
/*** sine wave ***/
const PROGMEM uint16_t sin_table[] = {
  2047  ,
  2060  ,
  2072  ,
  2085  ,
  2097  ,
  2110  ,
  2122  ,
  2135  ,
  2147  ,
  2160  ,
  2173  ,
  2185  ,
  2198  ,
  2210  ,
  2223  ,
  2235  ,
  2248  ,
  2260  ,
  2273  ,
  2285  ,
  2298  ,
  2310  ,
  2323  ,
  2335  ,
  2347  ,
  2360  ,
  2372  ,
  2385  ,
  2397  ,
  2409  ,
  2422  ,
  2434  ,
  2446  ,
  2459  ,
  2471  ,
  2483  ,
  2496  ,
  2508  ,
  2520  ,
  2532  ,
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
};
const PROGMEM uint16_t tri_table[] = {
/*** triangle wave ***/
  2055  ,
  2063  ,
  2071  ,
  2079  ,
  2087  ,
  2095  ,
  2103  ,
  2111  ,
  2119  ,
  2127  ,
  2135  ,
  2143  ,
  2151  ,
  2159  ,
  2167  ,
  2175  ,
  2183  ,
  2191  ,
  2199  ,
  2207  ,
  2215  ,
  2223  ,
  2231  ,
  2239  ,
  2247  ,
  2255  ,
  2263  ,
  2271  ,
  2279  ,
  2287  ,
  2295  ,
  2303  ,
  2311  ,
  2319  ,
  2327  ,
  2335  ,
  2343  ,
  2351  ,
  2359  ,
  2367  ,
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
};
const PROGMEM uint16_t sqr_table[] = {
/*** squre wave ***/
  4095  ,
  4095  ,
  4095  ,
  4095  ,
  4095  ,
  4095  ,
  4095  ,
  4095  ,
  4095  ,
  4095  ,
  4095  ,
  4095  ,
  4095  ,
  4095  ,
  4095  ,
  4095  ,
  4095  ,
  4095  ,
  4095  ,
  4095  ,
  4095  ,
  4095  ,
  4095  ,
  4095  ,
  4095  ,
  4095  ,
  4095  ,
  4095  ,
  4095  ,
  4095  ,
  4095  ,
  4095  ,
  4095  ,
  4095  ,
  4095  ,
  4095  ,
  4095  ,
  4095  ,
  4095  ,
  4095  ,
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
};
const PROGMEM uint16_t sawup_table[] = {
/*** sawtooth upword wave ***/
  0 ,
  3 ,
  7 ,
  11  ,
  15  ,
  19  ,
  23  ,
  27  ,
  31  ,
  35  ,
  39  ,
  43  ,
  47  ,
  51  ,
  55  ,
  59  ,
  63  ,
  67  ,
  71  ,
  75  ,
  79  ,
  83  ,
  87  ,
  91  ,
  95  ,
  99  ,
  103 ,
  107 ,
  111 ,
  115 ,
  119 ,
  123 ,
  127 ,
  131 ,
  135 ,
  139 ,
  143 ,
  147 ,
  151 ,
  155 ,
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
};
/*** sawtooth downword wave ***/
const PROGMEM uint16_t sawdown_table[] = {
  4091  ,
  4087  ,
  4083  ,
  4079  ,
  4075  ,
  4071  ,
  4067  ,
  4063  ,
  4059  ,
  4055  ,
  4051  ,
  4047  ,
  4043  ,
  4039  ,
  4035  ,
  4031  ,
  4027  ,
  4023  ,
  4019  ,
  4015  ,
  4011  ,
  4007  ,
  4003  ,
  3999  ,
  3995  ,
  3991  ,
  3987  ,
  3983  ,
  3979  ,
  3975  ,
  3971  ,
  3967  ,
  3963  ,
  3959  ,
  3955  ,
  3951  ,
  3947  ,
  3943  ,
  3939  ,
  3935  ,
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
};

#endif //_WAVETABLE_12bit_1k_H_
