ryood/ArduinoLFO/Arduino/MCP4922_DDS_WaveTableSize_Test/wavetable_8bit_256.h

/*
 * wavetable256.h
 * 
 * 2018.01.19
 * 
 */

#ifndef _WAVETABLE_8BIT_256_H_
#define _WAVETABLE_8BIT_256_H_

const PROGMEM  uint16_t sin_table[]  = {
  127,130,133,136,139,142,145,148,151,155,158,161,164,167,170,173,175,178,181,184,187,190,192,195,198,200,203,205,208,210,212,215,
  217,219,221,223,225,227,229,231,233,235,236,238,239,241,242,244,245,246,247,248,249,250,251,251,252,253,253,254,254,254,254,254,
  255,254,254,254,254,254,253,253,252,251,251,250,249,248,247,246,245,244,242,241,239,238,236,235,233,231,229,227,225,223,221,219,
  217,215,212,210,208,205,203,200,198,195,192,190,187,184,181,178,175,173,170,167,164,161,158,155,151,148,145,142,139,136,133,130,
  127,124,121,118,115,112,109,106,103,99,96,93,90,87,84,81,79,76,73,70,67,64,62,59,56,54,51,49,46,44,42,39,
  37,35,33,31,29,27,25,23,21,19,18,16,15,13,12,10,9,8,7,6,5,4,3,3,2,1,1,0,0,0,0,0,
  0,0,0,0,0,0,1,1,2,3,3,4,5,6,7,8,9,10,12,13,15,16,18,19,21,23,25,27,29,31,33,35,
  37,39,42,44,46,49,51,54,56,59,62,64,67,70,73,76,79,81,84,87,90,93,96,99,103,106,109,112,115,118,121,124
};

#endif // _WAVETABLE_8BIT_256_H_
