ryood/ArduinoLFO/(commit log)

2018-01-21 Add Arduino LFO ブロック図
    [Arduino LFO ブロック図.xlsx]
2018-01-26 Testing the wave shape button
2018-01-26 ButtonWaveShape as Interrupt
2018-01-26 use LED pin as PORT
2018-01-26 Show the wave shape on LEDs
2018-01-31 Add LPF
    [4th_Butterworth_VCVS_LPF.fzz]
2018-02-04 Add Output Board
    [Arduino LFO ブロック図.xlsx, ArduinoLFOwithUI_Output.fzz, ArduinoLFOwithUI_Output_r.fzz]
2018-02-08 Add eagle files
    [Arduino LFO ブロック図.xlsx, ArduinoLFO_Main.brd, ArduinoLFO_Main.sch, ArduinoLFO_MainBoard_Test.fzz]
2018-02-14 Board Design
    [ArduinoLFO_Main.brd, ArduinoLFO_Main.sch, ArduinoLFO_MainBoard_Test_修正.fzz]
2018-02-25 Main Boardはんだ付け完了
    [Arduino LFO Main Board テスト表.xlsx, Arduino LFO ブロック図.xlsx, ArduinoLFO_Main.brd, ArduinoLFO_Main.sch]
2018-02-25 ~50Hz, PulseWidth scope
2018-03-16 ArduinoLFO OutputBoard テスト表
    [Arduino LFO ブロック図.xlsx, ArduinoLFO OutputBoard テスト表.xlsx]
2018-03-19 はんだ付け完了
    [ArduinoLFO OutputBoard テスト表.xlsx, ArduinoLFO_Output_Board.brd, ArduinoLFOケース内配線.fzz]
2018-03-22 Add: ケース内配線図
    [ArduinoLFOケース内配線.fzz]
2018-03-27 Update: ArduinoLFOケース内配線
    [ArduinoLFOケース内配線.fzz]
2018-04-01 Update: the cad data of the Case .
    [ArduinoLFO_Case.dwg, ArduinoLFO_Case_Top.dwg]
2018-04-08 Add: MCP4922_OSC
    [ArduinoLFO OutputBoard テスト表.xlsx]
2018-05-05 10s Cycle ~ 10Hz
2018-05-06 Sampling Rate & MAX_RATE
    [ArduinoLFO SampleRate.xlsx]
